todocono/learningbot/pcb/v0.3.514/ArduinoNano LearningBot 5-14-18.dxf

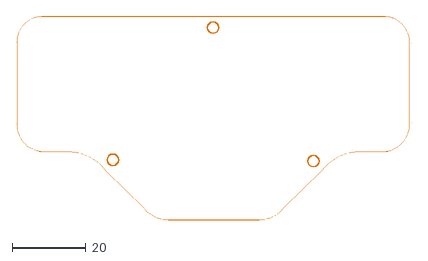
[picture p1: CAD file, 2018-05-30]
pcb/v0.3.514/ArduinoNano LearningBot 5-14-18.dxf
106.9 x 55.1
