todocono/learningbot/mechanical/Untitled-1.dxf

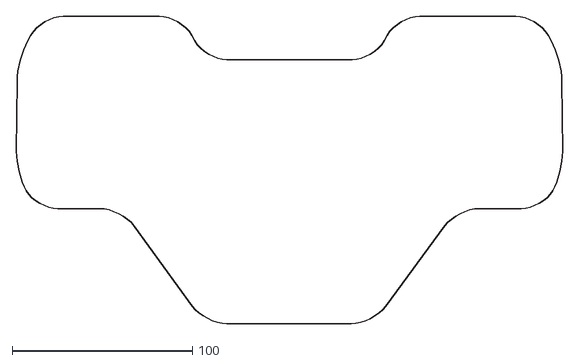
[picture p2: CAD file, 2018-03-31]
mechanical/Untitled-1.dxf
303.1 x 170.5
