todocono/learningbot/(list of files, cad)

Other CAD files:
mechanical/learningBot20180331.dxf
mechanical/learning bot Benzine6v2.dxf
