todocono/learningbot/pcb/v0.2.427/ArduinoNano LearningBot 4-21-18.brd

## EAGLE design pcb/v0.2.427/ArduinoNano LearningBot 4-21-18.brd (2018-05-14, an earlier design)

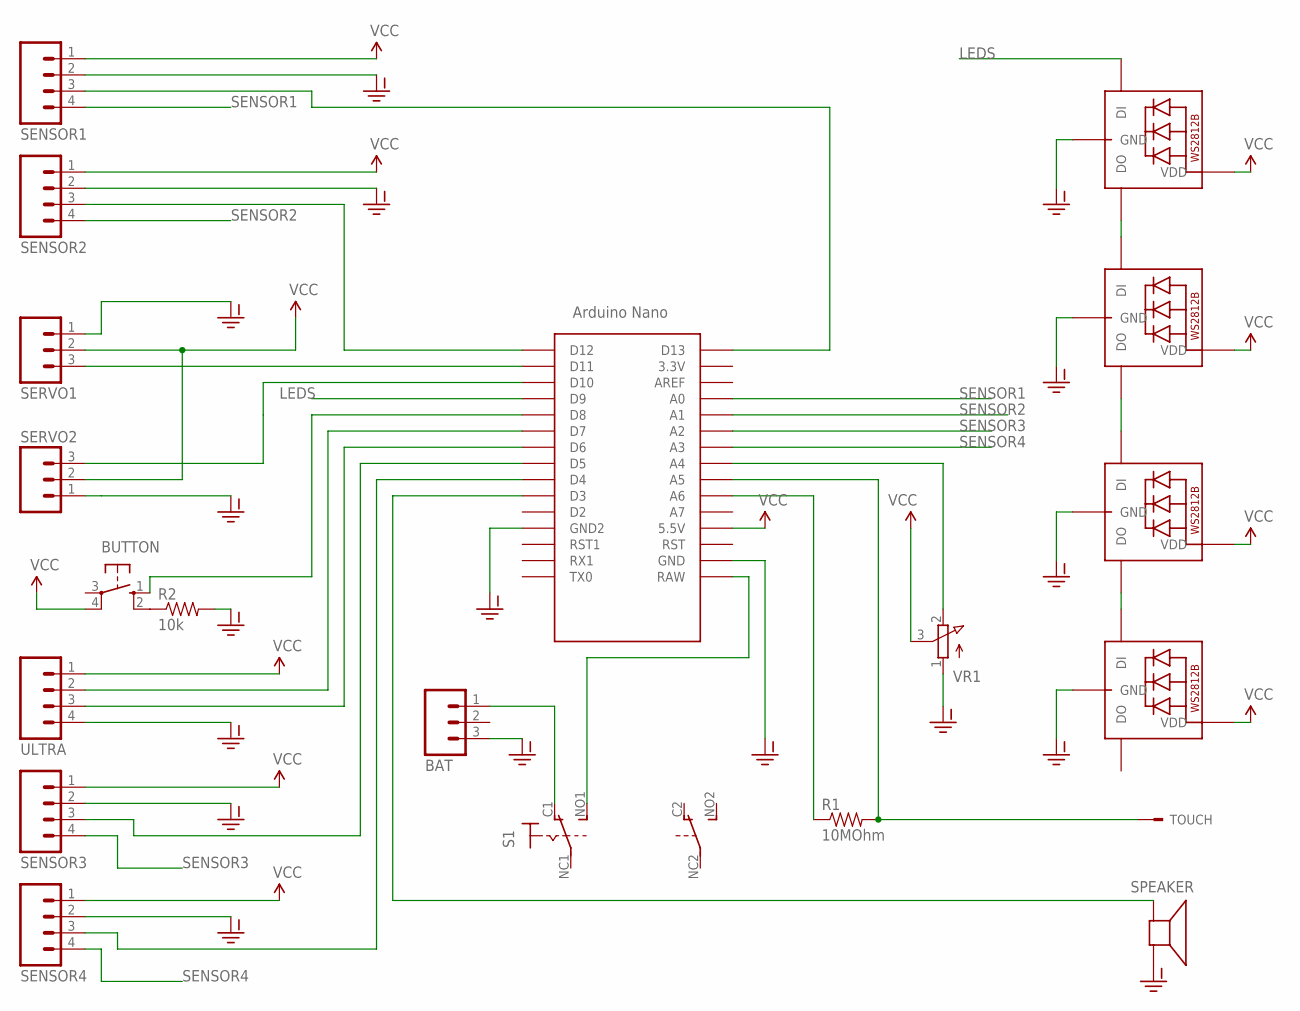
[picture p3: schematic ArduinoNano LearningBot 4-21-18.sch]

Parts:
BAT: M03POLAR; MOLEX-1X3
BUTTON: 10-XX; B3F-10XX
LED1, LED2, LED3, LED4: WS2812B5050; WS2812B
R1: 10MOhm; AXIAL-0.4
R2: 10k; AXIAL-0.4
S1: SWITCH_320-938; PS22F03
SENSOR1, SENSOR2, SENSOR3, SENSOR4: M04LOCK; 1X04_LOCK
SERVO1, SERVO2: M03LOCK; 1X03_LOCK
SPEAKER: SPEAKER/AL60P; AL60P
TOUCH: TOUCHSENSOR; TOUCH1
U$1: ARDUINO-CLONE_NANO
ULTRA: M04LOCK; 1X04_LOCK
VR1: 3RP/1610N-VERTICAL

Connections:
BUTTON: BUTTON.1 (S), U$1.D8
CAP_TOUCH_RECEIVE_PIN: R1.P$1 (1), U$1.A6
ECHO_PIN: U$1.D6, ULTRA.3
GND: BAT.3, LED1.3-GND (GND), LED2.3-GND (GND), LED3.3-GND (GND), LED4.3-GND (GND), R2.P$2 (2), SENSOR1.2, SENSOR2.2, SENSOR3.2, SENSOR4.2, SERVO1.1, SERVO2.1, SPEAKER.1 (+), U$1.GND, U$1.GND1 (GND2), ULTRA.4, VR1.1 (A)
IR_SENSOR1_DO: SENSOR2.3, U$1.D12
IR_SENSOR2_DO: SENSOR3.3, U$1.D5
LDR1_DO: SENSOR1.3, U$1.D13
LDR2_DO: SENSOR4.3, U$1.D4
LEDS: LED1.4-DIN (DI), U$1.D9
unnamed: LED2.2-DOUT (DO), LED3.4-DIN (DI)
unnamed: BUTTON.2 (S1), R2.P$1 (1)
unnamed: LED3.2-DOUT (DO), LED4.4-DIN (DI)
unnamed: LED1.2-DOUT (DO), LED2.4-DIN (DI)
unnamed: SERVO1.3, U$1.D11
unnamed: BAT.1, S1.C1 (O)
POTPIN: U$1.A4, VR1.2 (E)
RAWIN: S1.NO1 (S), U$1.RAW
SENSOR1: SENSOR1.4, U$1.A0
SENSOR2: SENSOR2.4, U$1.A1
SENSOR3: SENSOR3.4, U$1.A2
SENSOR4: SENSOR4.4, U$1.A3
SERVO2_PIN: SERVO2.3, U$1.D10
SPEAKERPIN: SPEAKER.2 (-), U$1.D3
TOUCH: R1.P$2 (2), TOUCH.P$1, U$1.A5
TRIG_PIN: U$1.D7, ULTRA.2
VCC: BUTTON.4 (P1), LED1.1-VDD (VDD), LED2.1-VDD (VDD), LED3.1-VDD (VDD), LED4.1-VDD (VDD), SENSOR1.1, SENSOR2.1, SENSOR3.1, SENSOR4.1, SERVO1.2, SERVO2.2, U$1.5V (5.5V), ULTRA.1, VR1.3 (S)

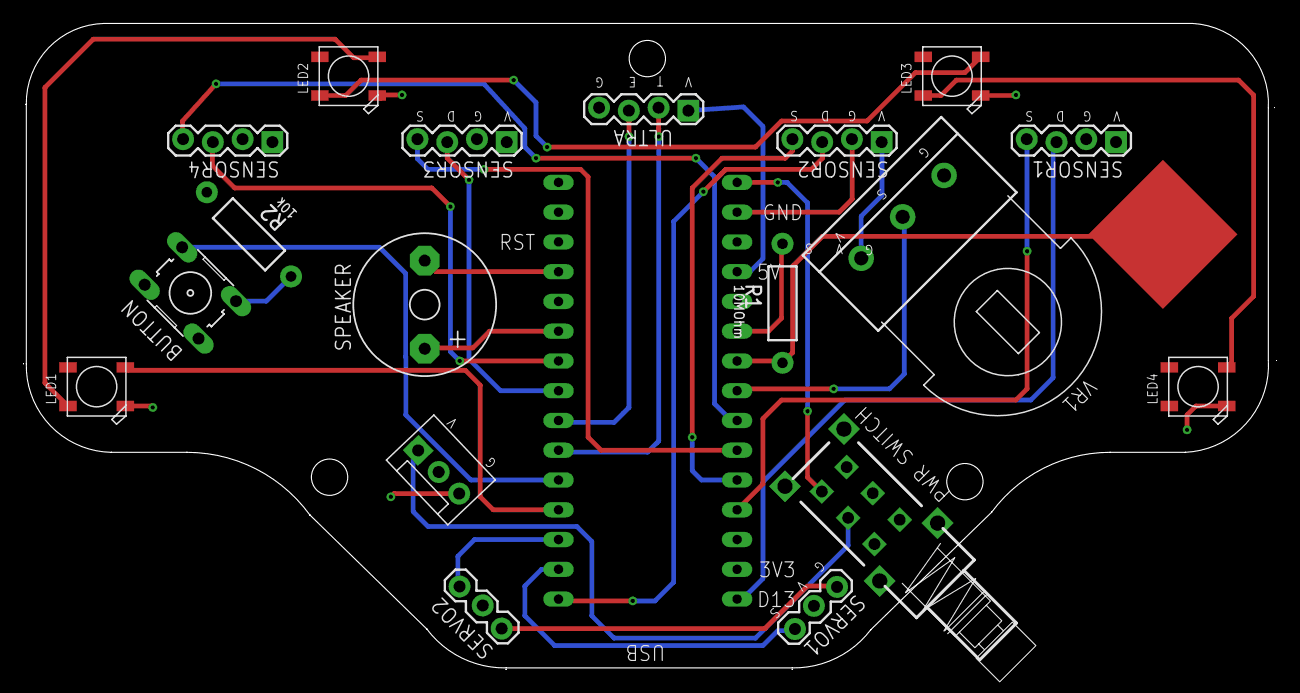
[picture p4: board ArduinoNano LearningBot 4-21-18.brd from above]

Board: 2 copper layers, 106.9 x 55.1 mm, 20 parts (0 on the bottom side), 26 nets.
