todocono/learningbot/pcb/v0.1/ArduinoNano LearningBot 4-17-18.brd

## EAGLE design pcb/v0.1/ArduinoNano LearningBot 4-17-18.brd (2018-04-20, an earlier design)

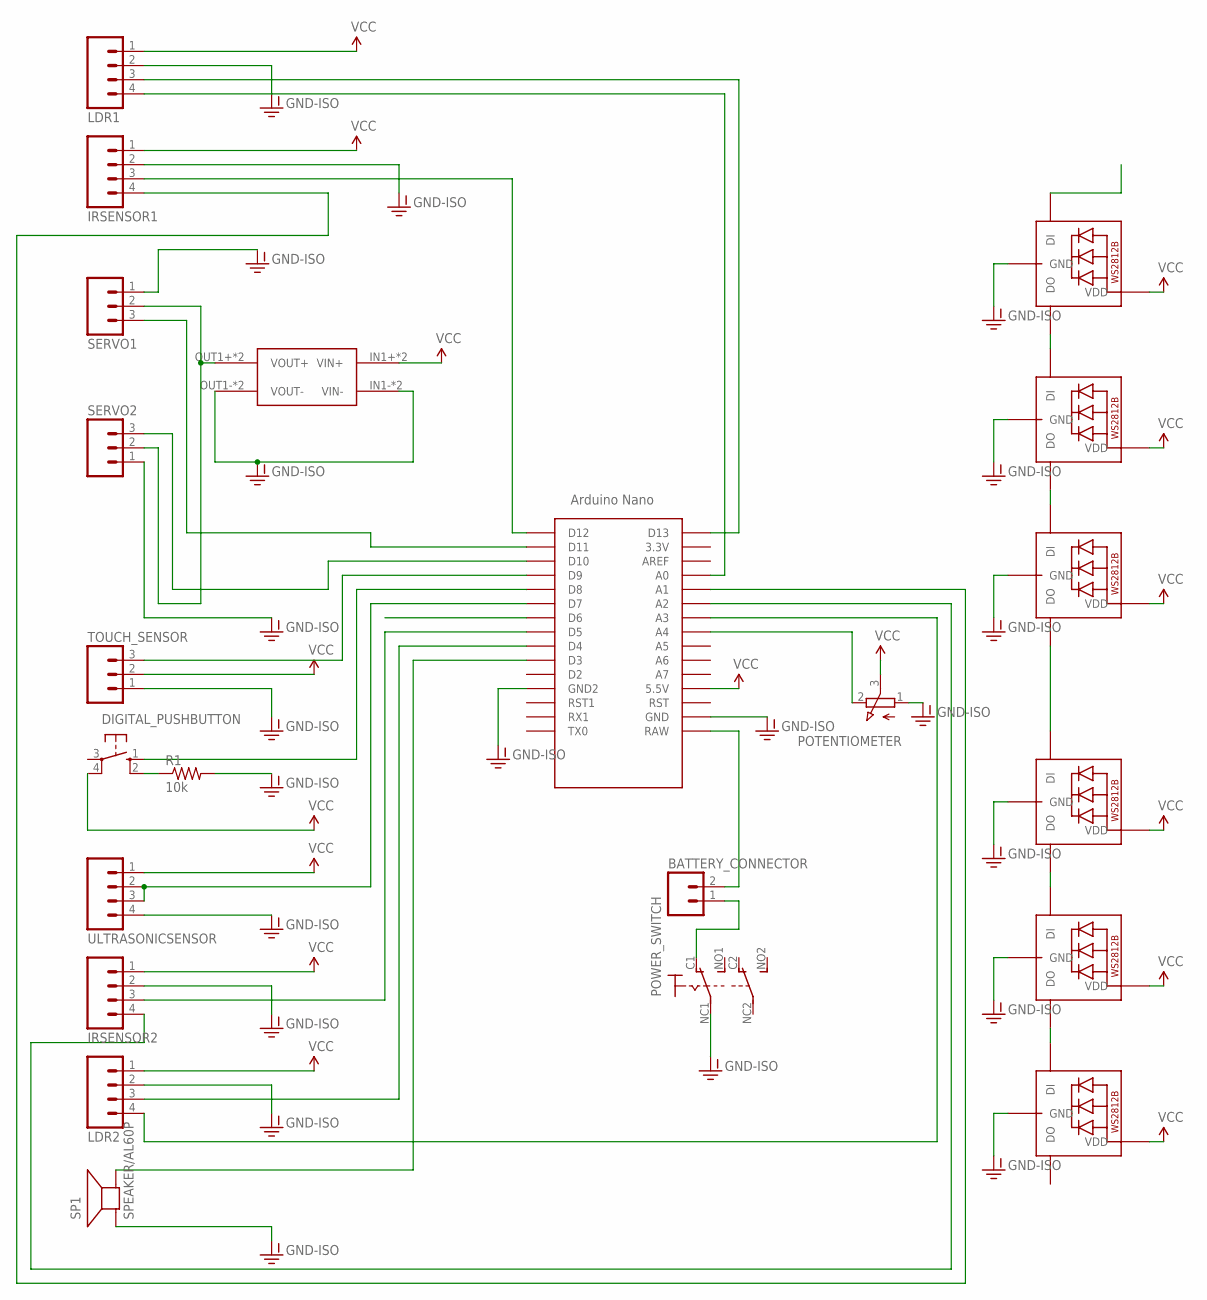
[picture p5: schematic ArduinoNano LearningBot 4-17-18.sch]

Parts:
BATTERY_CONNECTOR: M02-JST-2-PTH-NO_SILK; JST-2-PTH-NS
DIGITAL_PUSHBUTTON: 10-XX; B3F-10XX
IRSENSOR1, IRSENSOR2: M04LOCK; 1X04_LOCK
LDR1, LDR2: M04LOCK; 1X04_LOCK
LED-1, LED-2, LED-3, LED-4, LED-5, LED-6: WS2812B5050; WS2812B
POTENTIOMETER: 3RP/1610N-VERTICAL
POWER_SWITCH: SWITCH_320-938; PS22F03
R1: 10k; AXIAL-0.4
SERVO1, SERVO2: M03LOCK; 1X03_LOCK
SP1: SPEAKER/AL60P; AL60P
TOUCH_SENSOR: M03LOCK; 1X03_LOCK
U$1: ARDUINO-CLONE_NANO
U$3: MP1584; DC-BRICK
ULTRASONICSENSOR: M04LOCK; 1X04_LOCK

Connections:
BUTTON: DIGITAL_PUSHBUTTON.1 (S), U$1.D8
GND: IRSENSOR1.2, IRSENSOR2.2, LDR1.2, LDR2.2, LED-1.3-GND (GND), LED-2.3-GND (GND), LED-3.3-GND (GND), LED-4.3-GND (GND), LED-5.3-GND (GND), LED-6.3-GND (GND), POTENTIOMETER.1 (A), POWER_SWITCH.NC1, R1.P$2 (2), SERVO1.1, SERVO2.1, SP1.1 (+), TOUCH_SENSOR.1, U$1.GND, U$1.GND1 (GND2), U$3.IN1- (VIN-), U$3.IN2- (VIN-), U$3.OUT1- (VOUT-), U$3.OUT2- (VOUT-), ULTRASONICSENSOR.4
IR_SENSOR1_AO: IRSENSOR1.4, U$1.A1
IR_SENSOR1_DO: IRSENSOR1.3, U$1.D12
IR_SENSOR2_AO: IRSENSOR2.4, U$1.A2
IR_SENSOR2_DO: IRSENSOR2.3, U$1.D5
LDR1_AO: LDR1.4, U$1.A0
LDR1_DO: LDR1.3, U$1.D13
LDR2_AO: LDR2.4, U$1.A3
LDR2_DO: LDR2.3, U$1.D4
LED-1: LED-2.4-DIN (DI), U$1.D6
unnamed: LED-1.4-DIN (DI), LED-3.2-DOUT (DO)
unnamed: LED-4.2-DOUT (DO), LED-5.4-DIN (DI)
unnamed: DIGITAL_PUSHBUTTON.2 (S1), R1.P$1 (1)
unnamed: LED-5.2-DOUT (DO), LED-6.4-DIN (DI)
unnamed: LED-2.2-DOUT (DO), LED-3.4-DIN (DI)
unnamed: LED-1.2-DOUT (DO), LED-4.4-DIN (DI)
unnamed: BATTERY_CONNECTOR.1, POWER_SWITCH.C1 (O)
POTPIN: POTENTIOMETER.2 (E), U$1.A4
RAWIN: BATTERY_CONNECTOR.2, U$1.RAW
SERVO1_PIN: SERVO1.3, U$1.D11
SERVO2_PIN: SERVO2.3, U$1.D10
SERVOVCC: SERVO1.2, SERVO2.2, U$3.OUT1+ (VOUT+), U$3.OUT2+ (VOUT+)
SPEAKERPIN: SP1.2 (-), U$1.D3
TOUCH_SENSOR: TOUCH_SENSOR.3, U$1.D9
ULTRASONICSENSOR_PIN: U$1.D7, ULTRASONICSENSOR.2, ULTRASONICSENSOR.3
VCC: DIGITAL_PUSHBUTTON.4 (P1), IRSENSOR1.1, IRSENSOR2.1, LDR1.1, LDR2.1, LED-1.1-VDD (VDD), LED-2.1-VDD (VDD), LED-3.1-VDD (VDD), LED-4.1-VDD (VDD), LED-5.1-VDD (VDD), LED-6.1-VDD (VDD), POTENTIOMETER.3 (S), TOUCH_SENSOR.2, U$1.5V (5.5V), U$3.IN1+ (VIN+), U$3.IN2+ (VIN+), ULTRASONICSENSOR.1

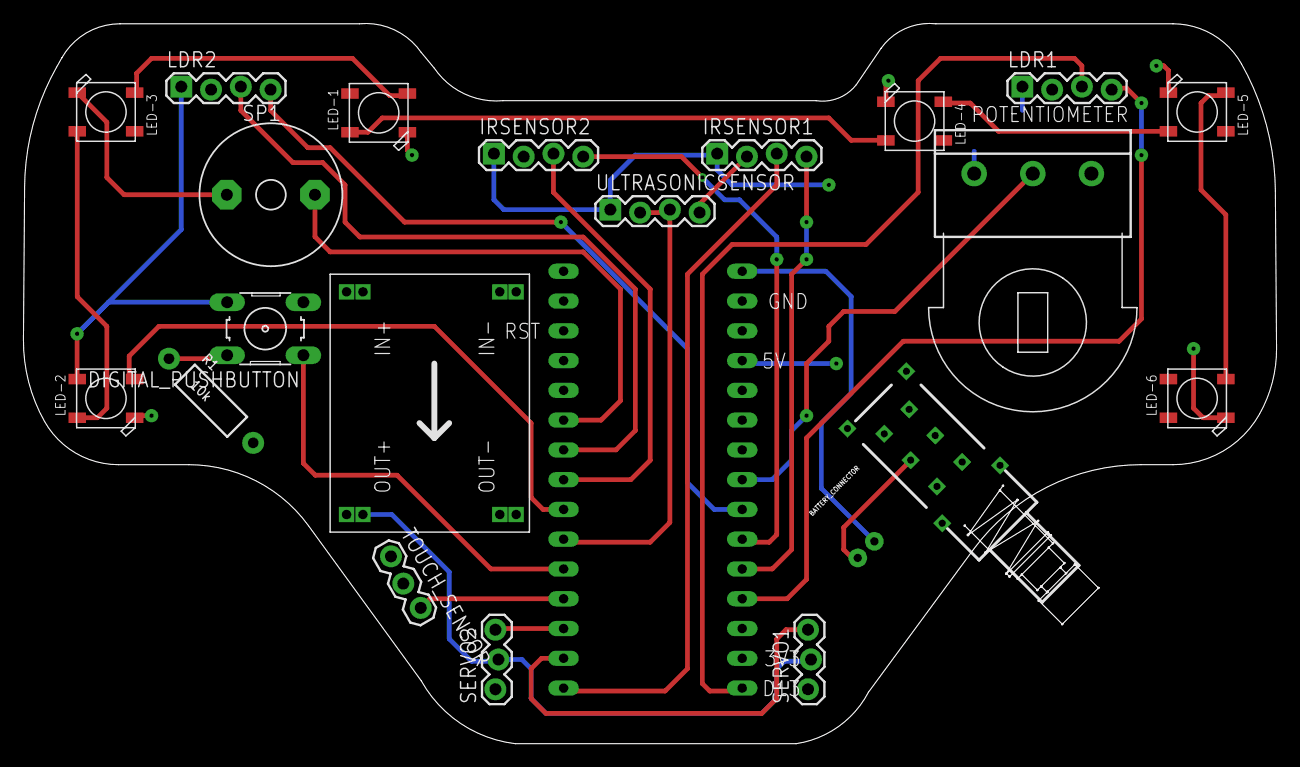
[picture p6: board ArduinoNano LearningBot 4-17-18.brd from above]

Board: 2 copper layers, 106.9 x 61.4 mm, 22 parts (0 on the bottom side), 27 nets.
