todocono/learningbot/pcb/v0.1/ArduinoNano LearningBot 3-30-18.brd

## EAGLE design pcb/v0.1/ArduinoNano LearningBot 3-30-18.brd (2018-03-31, an earlier design)

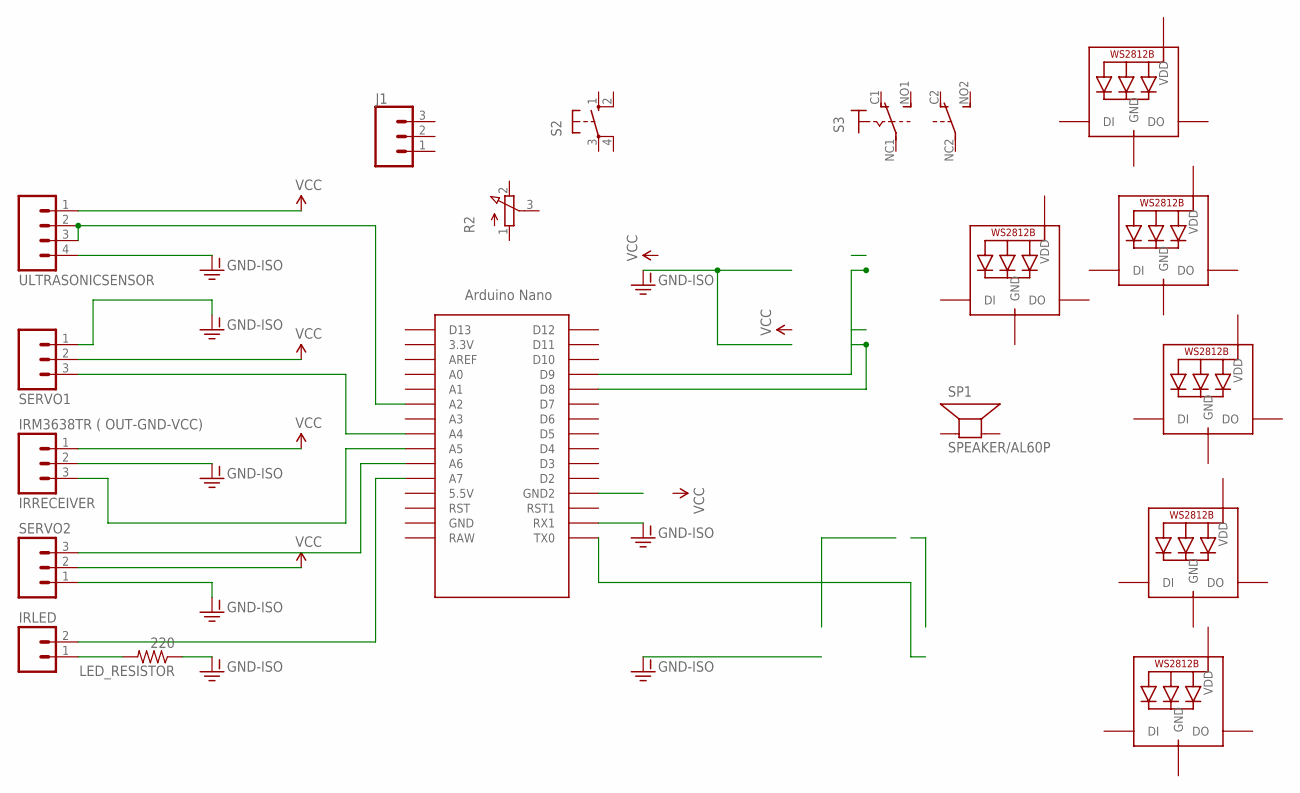
[picture p7: schematic ArduinoNano LearningBot 3-30-18.sch]

Parts:
IRLED: M02LOCK; 1X02_LOCK
IRRECEIVER: IRM3638TR ( OUT-GND-VCC); 1X03_LOCK
J1: CONN_03-SCREW-5MM; SCREWTERMINAL-5MM-3
LED1, LED2, LED3, LED4, LED5, LED6: WS2812B5050; WS2812B
LED_RESISTOR: 220; AXIAL-0.4
R2: 3RP/1610N-VERTICAL
S2: 10-XX; B3F-10XX
S3: SWITCH_320-938; PS22F03
SERVO1, SERVO2: M03LOCK; 1X03_LOCK
SP1: SPEAKER/AL60P; AL60P
U$1: ARDUINO-CLONE_NANO
ULTRASONICSENSOR: M04LOCK; 1X04_LOCK

Connections:
A0: U$1.D8
A1: U$1.D9
ARDUINORAW: U$1.TX0
GND: LED1.3-GND (GND), LED2.3-GND (GND), LED3.3-GND (GND), LED4.3-GND (GND), LED5.3-GND (GND), LED6.3-GND (GND)
GND-ISO: IRRECEIVER.2, LED_RESISTOR.P$1 (1), SERVO1.1, SERVO2.1, U$1.RX1, ULTRASONICSENSOR.4
IRGND: IRLED.1, LED_RESISTOR.P$2 (2)
IRLED: IRLED.2, U$1.A7
IRRECEIVER: IRRECEIVER.3, U$1.A5
SERVO1: SERVO1.3, U$1.A4
SERVO2: SERVO2.3, U$1.A6
ULTRASONICSENSOR: U$1.A2, ULTRASONICSENSOR.2, ULTRASONICSENSOR.3
VCC: IRRECEIVER.1, SERVO1.2, SERVO2.2, U$1.GND1 (GND2), ULTRASONICSENSOR.1
VDD: LED1.1-VDD (VDD), LED2.1-VDD (VDD), LED3.1-VDD (VDD), LED4.1-VDD (VDD), LED5.1-VDD (VDD), LED6.1-VDD (VDD)

Board: 2 copper layers, 18 parts (0 on the bottom side), 10 nets, no tracks yet.
