todocono/learningbot/pcb/v0.1/ArduinoNano LearningBot 3-15-18.brd

## EAGLE design pcb/v0.1/ArduinoNano LearningBot 3-15-18.brd (2018-04-24, an earlier design)

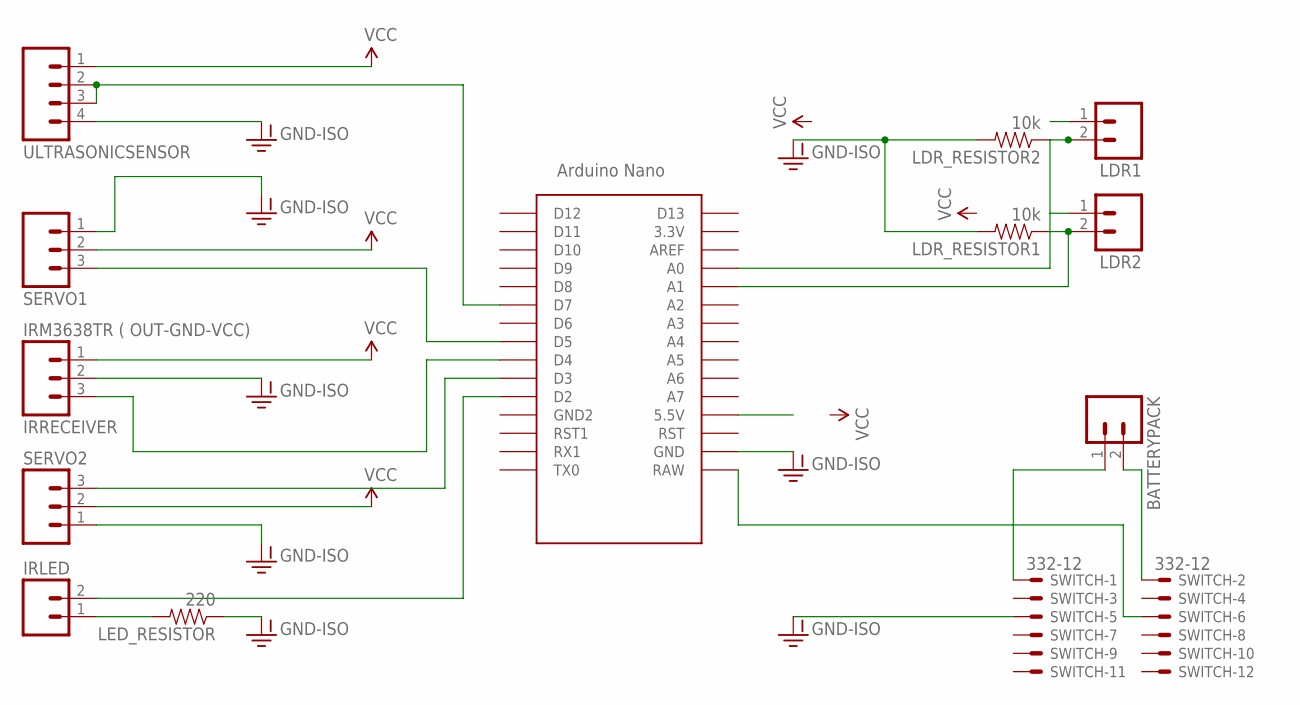
[picture p8: schematic ArduinoNano LearningBot 3-15-18.sch]

Parts:
BATTERYPACK: M02PTH; 1X02
IRLED: M02LOCK; 1X02_LOCK
IRRECEIVER: IRM3638TR ( OUT-GND-VCC); 1X03_LOCK
LDR1, LDR2: M02LOCK; 1X02_LOCK
LDR_RESISTOR1, LDR_RESISTOR2: 10k; AXIAL-0.4
LED_RESISTOR: 220; AXIAL-0.4
SERVO1, SERVO2: M03LOCK; 1X03_LOCK
SWITCH: 332-12
U$1: NANO
ULTRASONICSENSOR: M04LOCK; 1X04_LOCK

Connections:
A0: LDR2.2, LDR_RESISTOR1.P$1 (1), U$1.A1
A1: LDR1.2, LDR_RESISTOR2.P$1 (1), U$1.A0
ARDUINORAW: SWITCH.6, U$1.RAW
GND: BATTERYPACK.1, SWITCH.1
GND-ISO: IRRECEIVER.2, LDR_RESISTOR1.P$2 (2), LDR_RESISTOR2.P$2 (2), LED_RESISTOR.P$1 (1), SERVO1.1, SERVO2.1, U$1.GND, ULTRASONICSENSOR.4
GNDARDUINO: SWITCH.5
IRGND: IRLED.1, LED_RESISTOR.P$2 (2)
IRLED: IRLED.2, U$1.D2
IRRECEIVER: IRRECEIVER.3, U$1.D4
RAW: BATTERYPACK.2, SWITCH.2
SERVO1: SERVO1.3, U$1.D5
SERVO2: SERVO2.3, U$1.D3
ULTRASONICSENSOR: U$1.D7, ULTRASONICSENSOR.2, ULTRASONICSENSOR.3
VCC: IRRECEIVER.1, LDR1.1, LDR2.1, SERVO1.2, SERVO2.2, U$1.5V (5.5V), ULTRASONICSENSOR.1

Board: 2 copper layers, 13 parts (0 on the bottom side), 13 nets, no tracks yet.
