todocono/learningbot/(threads)

Thread 1 (2018-07-01):

Header pins missing

todocono, 2018-07-01:
We could use three or four connectors of 3 pins (instead of the actual 2 ones called servo1 and 2)
Layout of sensor1 is somewhat tricky currently because the switch is a bit tall.

Labels should have connector name (J1 -4 ?) and a letter to simbolize the signal. For example G, V and D11.

No need to have the extra pins connected to PWM

Thread 2 (2018-07-01):

Missing labels on pins of sensors

todocono, 2018-07-01:
Need to add labels of the pin functions. This would make it easier to understand how to connect sensors to them and also to use the pins for other purposes like connecting an LED.

Ideally we could rework fonts to prioritize learnability

Thread 3 (2018-07-01):

Glued connectors

todocono, 2018-07-01:
Both pot and sensors are prone to be twisted when the board is used in diy activities.

Using non-liquid super glue prior to soldering would solve this issue.

Thread 4 (2018-07-01):

Battery connector

todocono, 2018-07-01:
We had 5 issues in 12 boards related to:
- connected the battery to the ISP header
- were unsure where to connect
- asked why there were two cables coming out of the battery

We would benefit from placing the battery connector clearly apart from other components, using silk screen to identify BAT with an arrow, using 90 degree connector ( same orientation as switch ) and trying to purchase batteries with only one cable

Switch should have a label ON/OFF

Thread 6 (2018-07-01):

Polyswitch

todocono, 2018-07-01:
Given the amount of fried boards, let’s add a poly switch similar to the one duinobot v1.2 has

todocono, 2018-07-01:
An alternative would be to have a modified battery with the mentioned poly switch

Thread 7 (2018-07-01):

Capacitive touch

todocono, 2018-07-01:
We need to re test why the touch sensor is not working. Then either remove it or change the configuration

Thread 8 (2018-07-01):

PWM out

todocono, 2018-07-01:
Reconsidering the pin out of the Arduino, we could have the digital pins that connect to the sensors linked with the possibility of using PWM. For example, 5, 6, 9 & 10
