todocono/learningbot/(commit log)

2018-03-30 This is the first commit
    This is a schematic for Learning Bot with Arduino Nano. Note that it has a IR Reciever.
    [ArduinoNano LearningBot 3-15-18.brd]
2018-03-30 Here is the schematic
    [ArduinoNano LearningBot 3-15-18.sch]
2018-03-30 added folders
    [ArduinoNano LearningBot 3-15-18.brd, ArduinoNano LearningBot 3-15-18.sch]
2018-03-31 LearningBot Board Shape
    for illustrator
    [learning bot Benzine6v2.dxf]
2018-03-31 footprints confirmed
    [ArduinoNano LearningBot 3-30-18.brd, ArduinoNano LearningBot 3-30-18.sch, Untitled-1.dxf, learning bot Benzine6v2.dxf, learningBot20180331.dxf]
2018-04-03 PCB and Schematic
    [ArduinoNano LearningBot 4-2-18.brd, ArduinoNano LearningBot 4-2-18.sch]
2018-04-03 With components placed
    [ArduinoNano LearningBot 4-2-18.brd, ArduinoNano LearningBot 4-2-18.sch]
2018-04-09 Added buck converter to baord to supply current to servos
    [ArduinoNano LearningBot 4-9-18.brd, ArduinoNano LearningBot 4-9-18.sch]
2018-04-11 added led-test
    [led-test-1.brd, led-test-1.sch]
2018-04-12 added led-test v2
    [led-test-1.brd, led-test-1.sch]
2018-04-12 gerber generated
    [DRILEGEND.CFG, led-test-1.brd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]
2018-04-12 gerber generated v2
2018-04-20 just some changes
    [ArduinoNano LearningBot 4-16-18.brd, ArduinoNano LearningBot 4-16-18.sch, ArduinoNano LearningBot 4-17-18.brd, ArduinoNano LearningBot 4-17-18.sch, ArduinoNano LearningBot 4-9-18 copy.brd, ArduinoNano LearningBot 4-9-18 copy.sch]
2018-04-21 Ready for inspection
    [ArduinoNano LearningBot 4-21-18.brd, ArduinoNano LearningBot 4-21-18.sch, ArduinoNano LearningBot 4-9-18 copy.dxf]
2018-04-24 moved into folders, minor comments
    [ArduinoNano LearningBot 3-15-18.brd, ArduinoNano LearningBot 3-15-18.sch, ArduinoNano LearningBot 3-30-18.brd, ArduinoNano LearningBot 3-30-18.sch, ArduinoNano LearningBot 4-16-18.brd, ArduinoNano LearningBot 4-16-18.sch, ArduinoNano LearningBot 4-17-18.brd, ArduinoNano LearningBot 4-17-18.sch]
2018-04-24 compiled library
    [ArduinoNano LearningBot 4-9-18 copy.dxf]
2018-04-24 New Board
    [ArduinoNano LearningBot 4-21-18.brd]
2018-04-25 Most recent
    [ArduinoNano LearningBot 4-21-18.brd]
2018-04-25 component placement 95%
    [ArduinoNano LearningBot 4-21-18.brd, ArduinoNano LearningBot 4-21-18.sch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]
2018-04-25 almost there!
    [ArduinoNano LearningBot 4-21-18.brd, ArduinoNano LearningBot 4-21-18.sch]
2018-04-26 changes to physical
    [ArduinoNano LearningBot 4-21-18.brd, ArduinoNano LearningBot 4-21-18.sch]
2018-04-27 changed designators and holes
    [ArduinoNano LearningBot 4-21-18.brd, ArduinoNano LearningBot 4-21-18.sch]
2018-05-01 most recent board
    [ArduinoNano LearningBot 4-21-18.brd, ArduinoNano LearningBot 4-21-18.sch]
2018-05-02 with gerbers
    [ArduinoNano LearningBot 4-21-18.brd, ArduinoNano LearningBot 4-21-18.sch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]
2018-05-14 Hopefully, the last one
    [ArduinoNano LearningBot 4-21-18.brd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]
2018-05-29 Arduino Code for Learning Bot
2018-05-30 just updating
    [ArduinoNano LearningBot 5-14-18.dxf]
2018-06-01 Better Arduino Code
    This code has an added function to also allow the user to test analog functions.
2018-06-06 ulstrasonic shouldn't bug out with this
    [Learningbot_Test_All_Peripheries_6-6-18.ino]
2018-06-06 Fix so that at startup, all neopixels turn pink
    [Learningbot_Test_All_Peripheries_6-6-18.ino]
2018-06-06 Even better fix
    To make all neopixels change color at the same time, I repeat the function three times. The rapid succession eliminates any rogue colors that appear before the human eye can detect them.
    [Learningbot_Test_All_Peripheries_6-6-18.ino]
